dexterbg/WifiConsole/(commit log)

2019-10-06 - Docs: fixed battery estimation
2020-01-02 - Add SOC & 12V level display on wakeup - Config reader update
